Jwf68/Ch-air-/Documents/ElectricalDiagram.pdf

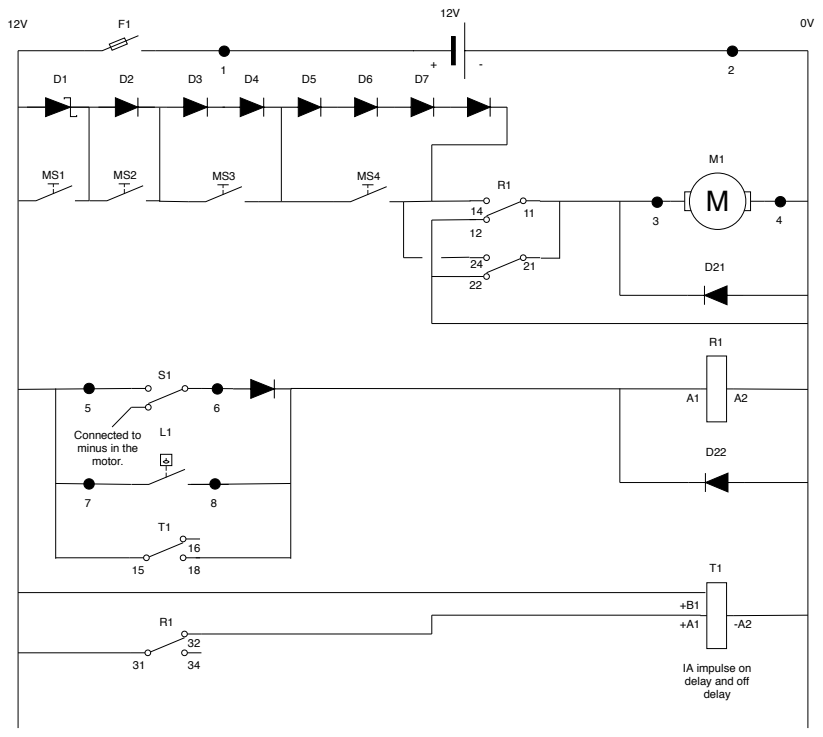
[picture p8: page 1]
